vab19790h/Mechatronics-Project-Arduino-code/Scan from 2022-03-25 11_27_54 PM.jpg

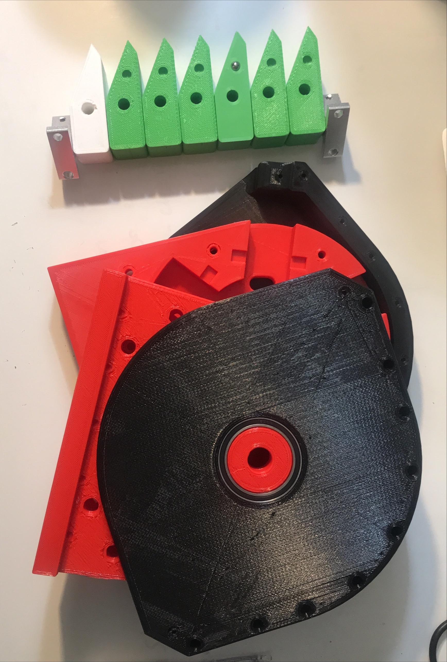
Scan from 2022-03-25 11_27_54 PM.jpg
