vab19790h/Mechatronics-Project-Arduino-code/I1.jpg

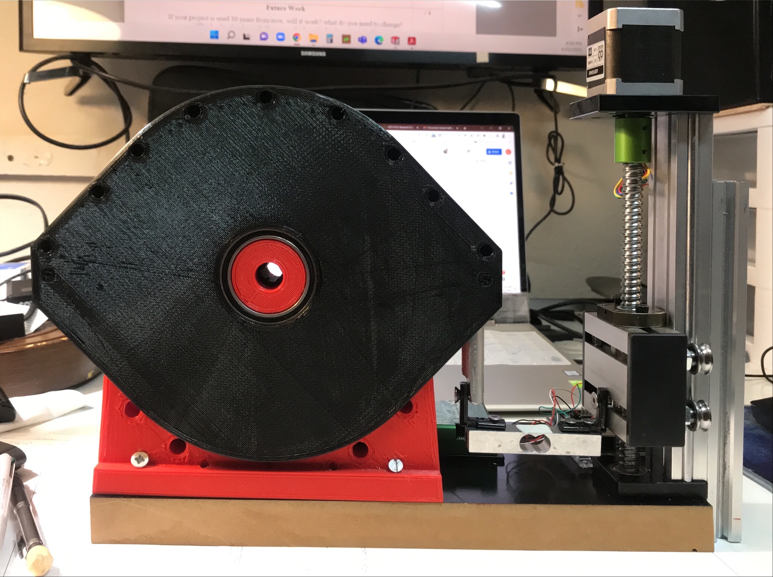
I1.jpg
