vab19790h/Mechatronics-Project-Arduino-code/Final Project Report_Mechatronics_VB.pdf

1

## Final Project Report: Mechatronics

## Title: Radial Force Measurement System (RFMS) for Flow Diverters and Stents

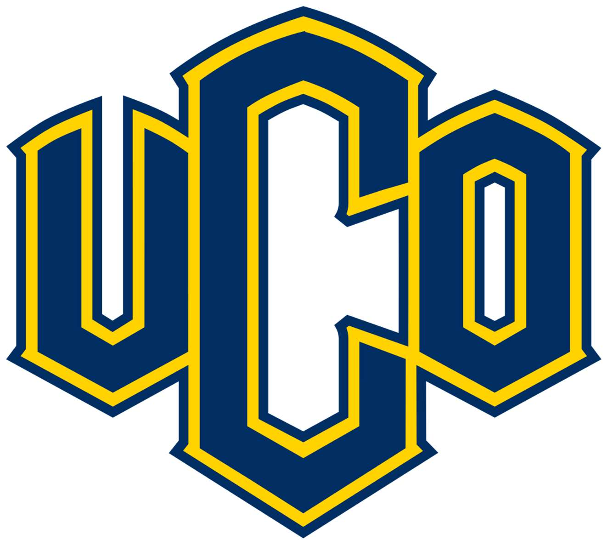
[picture p3: figure]

Spring 2022

Academic Advisor 1: Dr. Nesreen Alsbou Academic Advisor 2: Dr. Abdellah Ait Moussa Academic Advisor 3: Dr. Mohammad Robi Hossan

By
Vishal Barot

2

## Abstract

In the research of developing Biodegradable Flow Diverters by Dr. Hossan and his team, analyzing the mechanical properties of the developed flow diverters are one of the most crucial subsections. The flow diverters have a mesh-like structure in a tubular form and investigate the radial force related to the hoop stress of the material in one of the requirements for the analysis of mechanical properties of the Flow Diverters produced by the team of researchers at UCO. The machine required to analyze this property is available in the market at a relatively high cost and also It would not be sensible to buy equipment that could only serve one purpose especially when It can be developed by engineering students if provided enough incentive and support. This solution is to develop a mechanism that would radially compress the stent to a smaller diameter while registering the force or pressure difference. This data can be later interpreted via a proper calibration of the system. The solution will save a considerable amount of expense while allowing students to have an invaluable chance of learning many aspects of developing a mechanism and a system that would be functional and applicable to the research work.

## Introduction

The current environment requires flow diverters to be non-permanent in the body to reduce the possibility of developing complications like late thrombosis and restenosis after having a metallic flow diverter being inserted in the brain arteries to cure the condition of a brain aneurysm. The Brain Aneurysm is the bulging of an area of the blood vessel mainly due to the weakening of the walls of the arteries. This formation is known as an aneurysm which could be fatal if ruptures. The use of flow diverters to cure the condition of the brain aneurysm is quite popular in the medical field due to its noninvasive method to cure the condition. Producing a biodegradable/bioresorbable flow diverter can not only cure the condition of brain aneurysm but also biodegrade over time and reduce or avoid the disadvantages that come along with the permanency of metallic flow diverters. In a manner to push forward, the research and development of such flow diverters will only help the current environment of health conditions of human beings. So, In a manner to further the process, the requirement of investigating the mechanical properties of the developed flow diverter is crucial. And If that goal can be achieved without making hefty expenses on the research budget would be considered a much better solution.

3

## Proposed Solution

Develop a mechanism that would radially compress the flow diverters and allow an electronic system to detect and collect the force versus displacement data during the testing process. The prototype of the mechanism can be 3D printed. The loadcell can be utilized to detect force variation using an Arduino and the data can be transmitted to a computer for data acquisition through a Bluetooth module. The mechanism can be operated using a power screw and stepper motor controlled again via an Arduino

## Design and Prototype

| The Prototype will register and collect radial force measurements. The following
fig. 1 demonstrates the schematics of the Initial Idea.

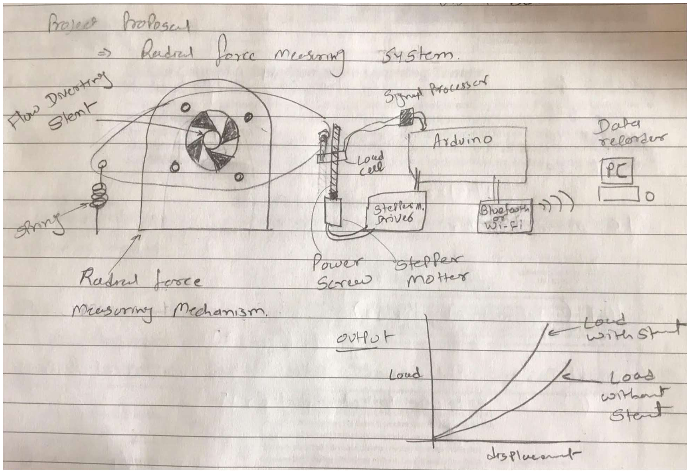
[picture p4: figure]

Fig. 1 Rough Schematics for the Radial Force Measurement Device

The following Fig. 2 demonstrates the flowchart of the functionality of the prototype. The flow diverter will be inserted into the mechanism which will be mechanically operated via a lead or power screw mechanism operated through a

4

stepper motor. The mechanism will also be connected to the load cell to register and collect the force measurement data through the radial compression of the flow diverters. Both load cell and stepper motor (via stepper motor driver) will be operated and controlled using an Arduino Uno microcontroller. The logical programming would initiate the test, collect the data during the radial compression and export the data to the monitoring computer via Bluetooth connectivity.

Fig. 2 Flowchart of the RFMS

Fig.3 illustrates the 3D modeling and simulation stage of the project and Fig 4 demonstrates the process of manufacturing the components of the mechanism using the additive manufacturing process.

Flow
Diverter

Radial
Force

Lead
Screw
Load Cell | Stepper Motor

Arduino

Computer

Bluetooth
Module

5

## Gantt chart for completing the project on time

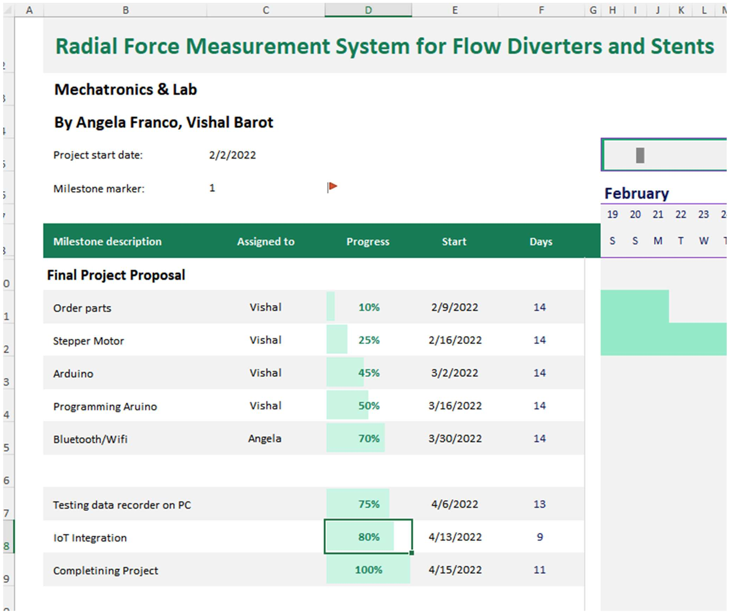
[picture p5: figure]
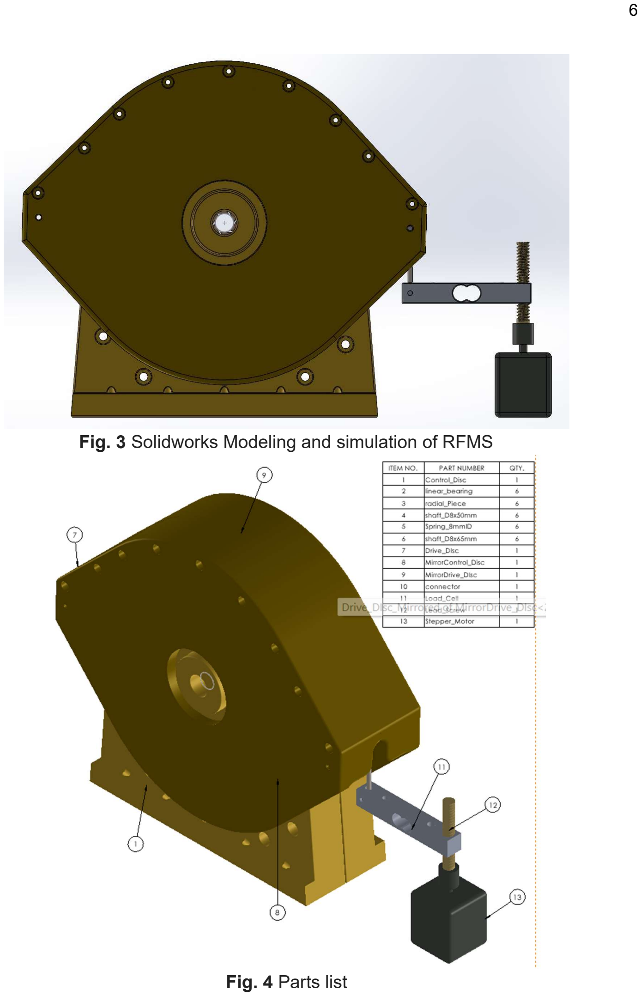
[picture p6: page 6]

6

Fig. 3 Solidworks Modeling and simulation of RFMS

Fig. 4 Parts list

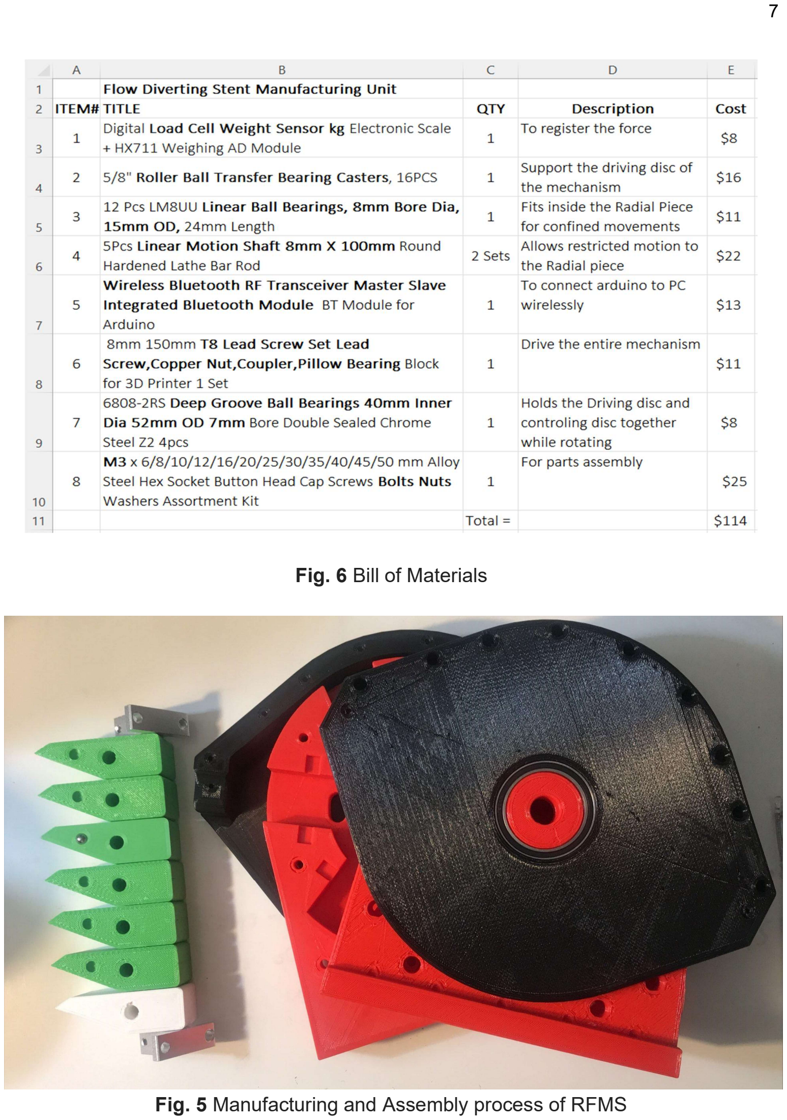
[picture p7: page 7]

7

Fig. 6 Bill of Materials

Fig. 5 Manufacturing and Assembly process of RFMS

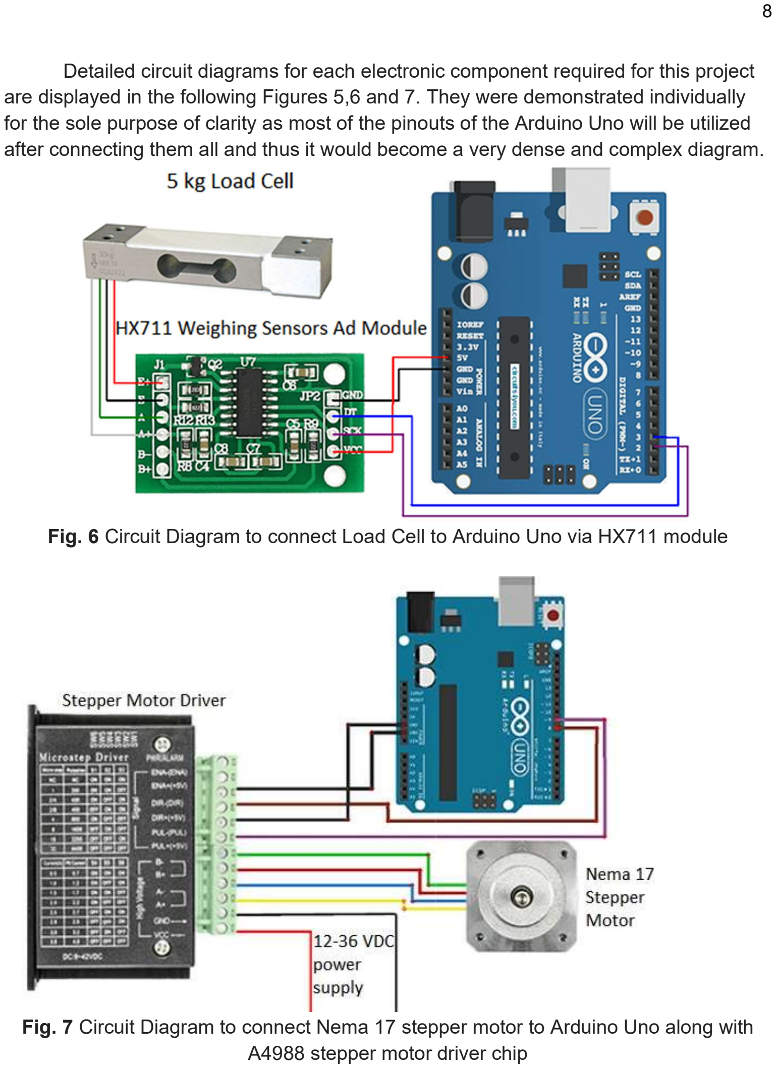
[picture p8: page 8]

8

| Detailed circuit diagrams for each electronic component required for this project
are displayed in the following Figures 5,6 and 7. They were demonstrated individually for the sole purpose of clarity as most of the pinouts of the Arduino Uno will be utilized after connecting them all and thus it would become a very dense and complex diagram.

Fig. 6 Circuit Diagram to connect Load Cell to Arduino Uno via HX711 module

Fig. 7 Circuit Diagram to connect Nema 17 stepper motor to Arduino Uno along with A4988 stepper motor driver chip

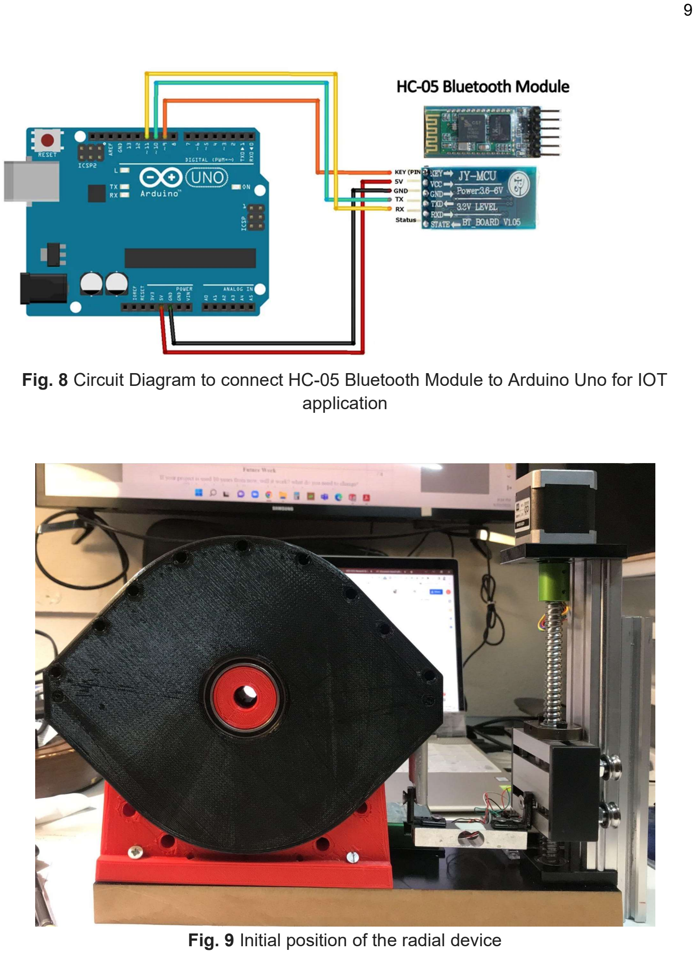
[picture p9: page 9]

9

Fig. 8 Circuit Diagram to connect HC-05 Bluetooth Module to Arduino Uno for IOT application

Fig. 9 Initial position of the radial device

10

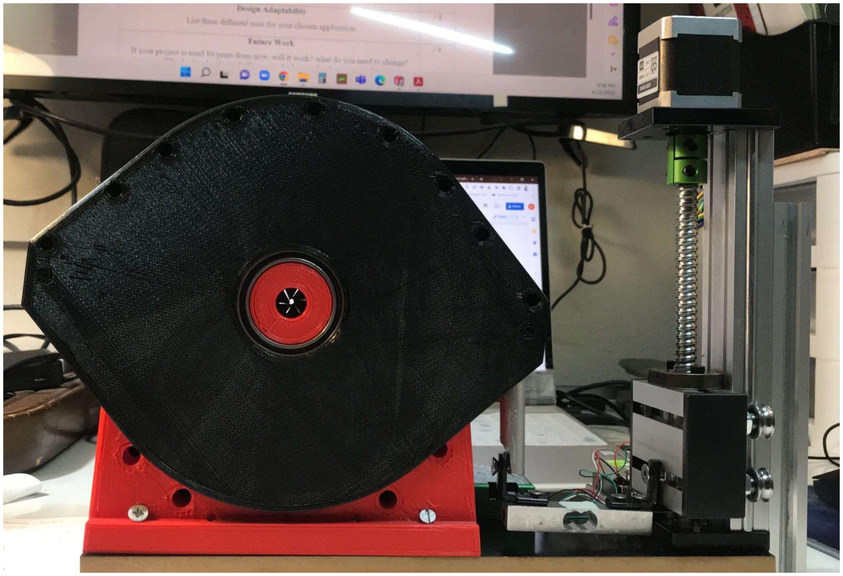
[picture p10: figure]

Fig. 10 Final position of the radial device

| Figures 8 and 9 demonstrate the completed project with its ideal position when
the radial mechanism is fully open to about 13 mm in diameter in Fig. 8 and closed down to about 1 mm diameter in Fig 9. The process of reducing the diameter through the mechanism will compress the flow diverter which will result in detecting a larger force value to estimate the radial force produced by the flow diverter.
| Click the link to watch the design and demonstration with some background
review of the project. https://youtu.be/eQT90Z1PZ-U

11

## Design Adaptability

Since the project is heavily concentrated on performing one task of measuring radial force, It can be used to measure radial compressive strength related to hoop stress of any flexible material with a cylindrical shape. It can be used to test pressurized flexible tubing to estimate the pressure of the tube without intruding into the fluid pipeline which is what most instruments do to measure the pressure of a pipeline. With certain modifications in mechanism, It can perform several types of mechanical testings that require force within the range of the load cell. There are several load cells available in the market with a higher capacity which can be an applicable variety of mechanical testing.

## Future Work

My project will work longer than 10 years if handled properly and performed regular maintenance and parts replacements in case of failure. But to make it highly accurate and precise, the parts of the mechanism should be manufactured out of metal and not from 3D printed materials via the CNC machining process and other industrialgrade manufacturing processes. Also, the load cell and microcontroller should be replaced with more reliable, high-quality replacements to ensure long-term consistent performance.

## Design Considerations and Engineering Standards

ISO 25539-1:2017: Cardiovascular implants — Endovascular devices — Part 1: Endovascular prostheses
ISO 25539-2:2012: Cardiovascular implants — Endovascular devices — Part 2: Vascular stents
ASTM F3067: Guide for Radial Loading of Balloon Expandable and Self Expanding Vascular Stents

12

## References

[1] Yu, Zhen, et al. “Design and Calibration of Torque Measurement System of Comprehensive Performance Test Instrument of Industrial Robot Reducer.” Computational Intelligence and Neuroscience, vol. 2022, Hindawi, 2022, pp. 8155818–8155818, https://doi.org/10.1155/2022/8155818.
[2] Maragkos, Georgios A., et al. “Overview of Different Flow Diverters and Flow Dynamics.” Neurosurgery, vol. 86, no. Supplement_1, Oxford University Press, 2020, pp. S21–S34, https://doi.org/10.1093/neuros/nyz323.
[3] Huang, Chenxi, et al. “A Deep Segmentation Network of Stent Structs Based on IoT for Interventional Cardiovascular Diagnosis.” IEEE Wireless Communications, vol. 28, no. 3, IEEE, 2021, pp. 36–43, https://doi.org/10.1109/MWC.001.2000407.
[4] Hoare, Daniel, et al. “The Future of Cardiovascular Stents: Bioresorbable and Integrated Biosensor Technology.” Advanced Science, vol. 6, no. 20, John Wiley & Sons, Inc, 2019, p. 1900856–n/a, https://doi.org/10.1002/advs.201900856.
[5] Link, Antonia, et al. “In Vitro Investigation of an Intracranial Flow Diverter with a Fibrin-Based, Hemostasis Mimicking, Nanocoating.” Biomedical Materials (Bristol), vol. 16, no. 1, IOP Publishing, 2020, pp. 015026–015026, https://doi.org/10.1088/1748-605X/abc8d3.
