vab19790h/Mechatronics-Project-Arduino-code/Screenshot 2022-03-25 225828.jpg

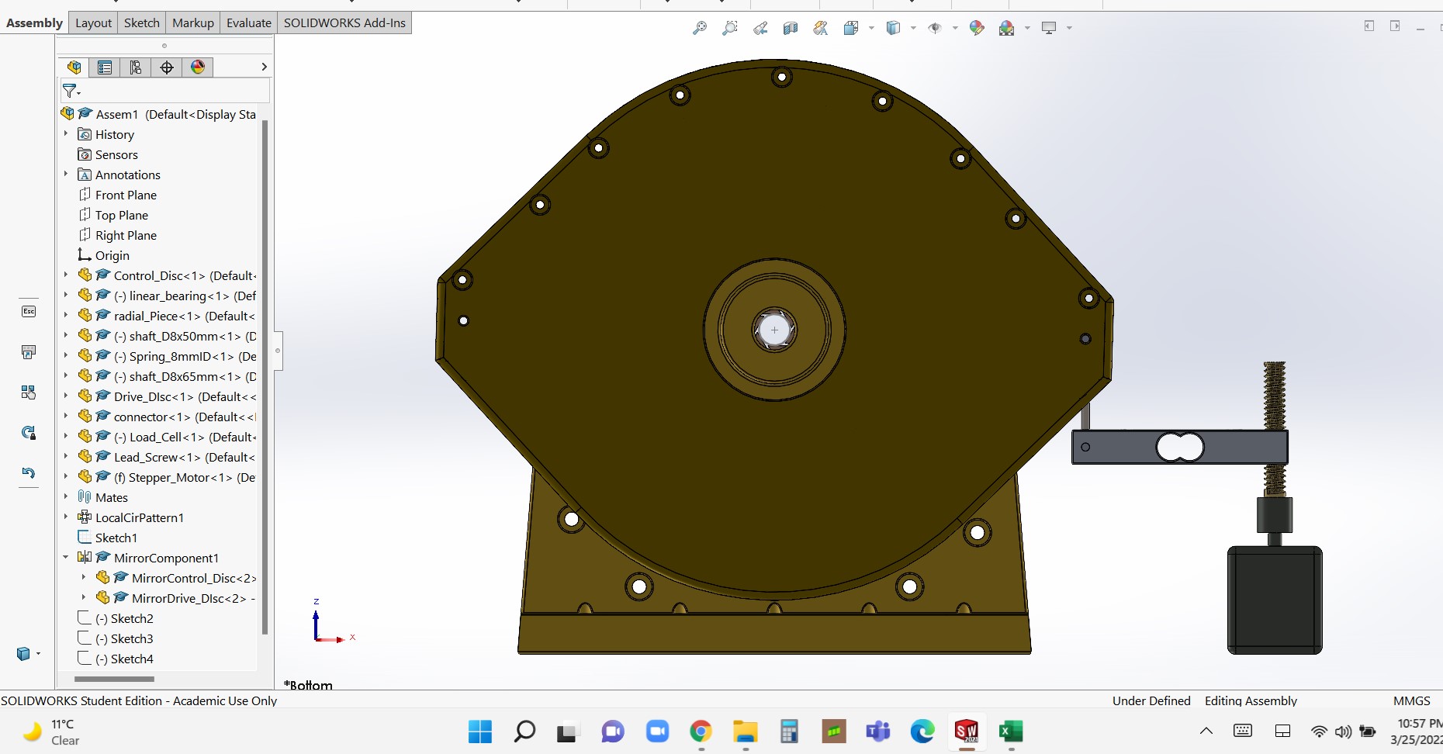
Screenshot 2022-03-25 225828.jpg
