vab19790h/Mechatronics-Project-Arduino-code/Screenshot 2022-04-25 134411.jpg

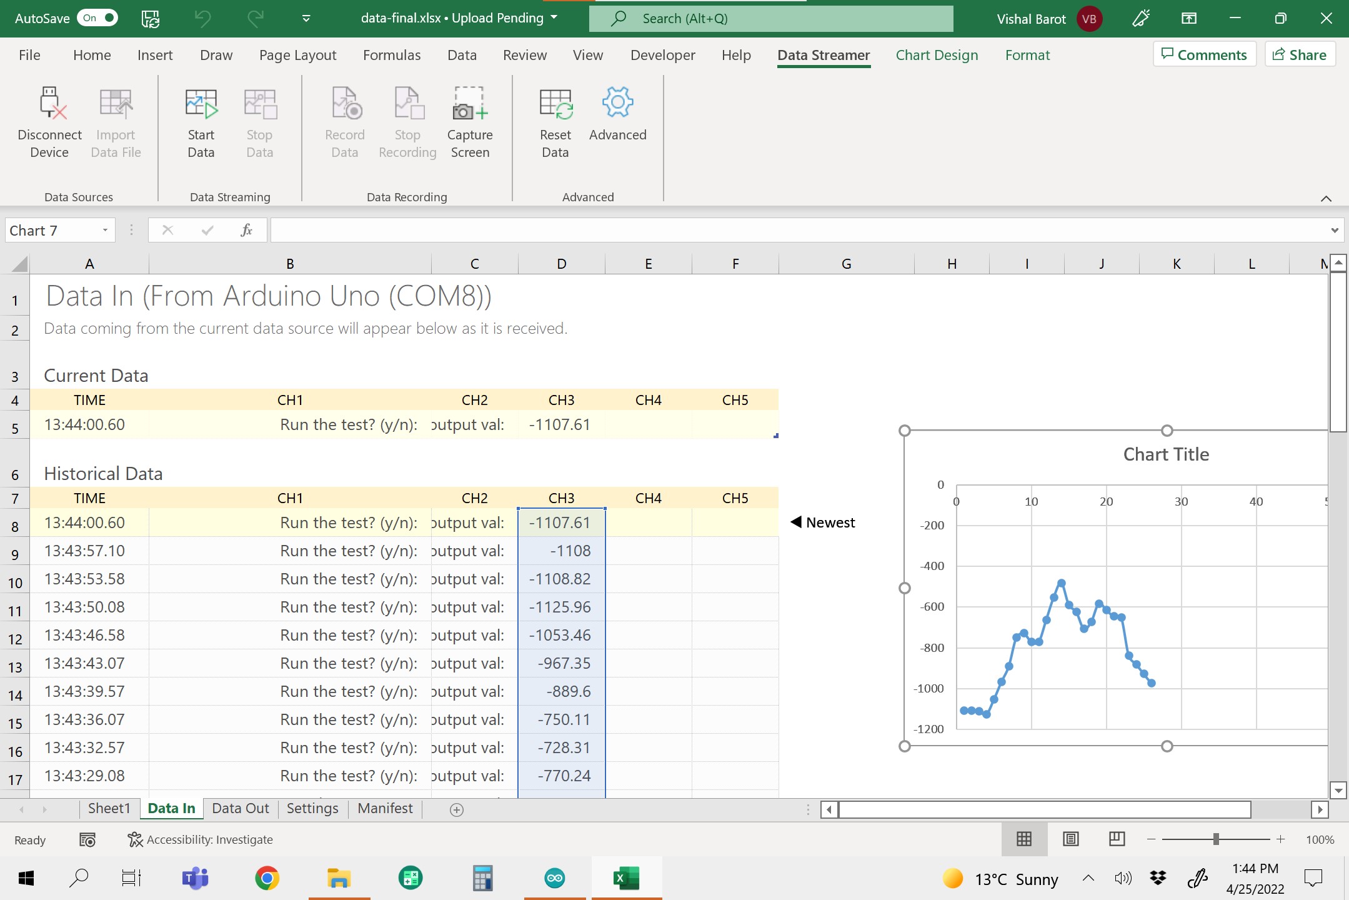
Screenshot 2022-04-25 134411.jpg
