vab19790h/Mechatronics-Project-Arduino-code/data-final.xlsx

Sheet: Data In
Data In (From Arduino Uno (COM8))
Data coming from the current data source will appear below as it is received.
Current Data
TIME | CH1 | CH2 | CH3 | CH4 | CH5 | CH6 | CH7 | CH8 | CH9 | CH10
16:32:52 | Run the test? (y/n): | Force: | -724.83
Historical Data
TIME | CH1 | CH2 | CH3 | CH4 | CH5 | CH6 | CH7 | CH8 | CH9 | CH10
16:32:52 | Run the test? (y/n): | Force: | -724.83
16:32:48 | Run the test? (y/n): | Force: | -723.26
16:32:45 | Run the test? (y/n): | Force: | -576.56
16:32:41 | Run the test? (y/n): | Force: | -576.72
16:32:38 | Run the test? (y/n): | Force: | -723.57
16:32:34 | Run the test? (y/n): | Force: | -725.41
16:32:31 | Run the test? (y/n): | Force: | -725.57
16:32:27 | Run the test? (y/n): | Force: | -708.52
16:32:24 | Run the test? (y/n): | Force: | -753.27
16:32:20 | Run the test? (y/n): | Force: | -763.02
16:32:17 | Run the test? (y/n): | Force: | -787.33
16:32:13 | Run the test? (y/n): | Force: | -752.53
16:32:10 | Run the test? (y/n): | Force: | -768.41
16:32:06 | Run the test? (y/n): | Force: | -768.41
16:32:03 | Run the test? (y/n): | Force: | -890.72
16:31:59 | Run the test? (y/n): | Force: | -914.65
16:31:56 | Run the test? (y/n): | Force: | -897.4
16:31:52 | Run the test? (y/n): | Force: | -999.06
16:31:49 | Run the test? (y/n): | Force: | -1143.04
16:31:45 | Run the test? (y/n): | Force: | -996.53
16:31:42 | Run the test? (y/n): | Force: | -995.74
16:31:38 | Run the test? (y/n): | Force: | -1142.79
16:31:35 | Run the test? (y/n): | Force: | -1139.46
16:31:31 | Run the test? (y/n): | Force: | -1139.24
16:31:28 | Run the test? (y/n): | Force: | -1139.51
16:31:24 | Run the test? (y/n): | Force: | -1258.44
16:31:21 | Run the test? (y/n): | Force: | -1186.24
16:31:17 | Run the test? (y/n): | Force: | -1323.69
16:31:14 | Run the test? (y/n): | Force: | -1299.48
16:31:10 | Run the test? (y/n): | Force: | -1335.02
16:31:07 | Run the test? (y/n): | Force: | -1336.96
16:31:03 | Run the test? (y/n): | Force: | -1354.73
16:31:00 | Run the test? (y/n): | Force: | -1250.24
16:30:56 | Run the test? (y/n): | Force: | -1255.76
16:30:53 | Run the test? (y/n): | Force: | -1380.74
16:30:49 | Run the test? (y/n): | Force: | -1246.38
16:30:46 | Run the test? (y/n): | Force: | -1085.31
16:30:42 | Run the test? (y/n): | Force: | -1067.92
16:30:39 | Run the test? (y/n): | Force: | -1051.52
16:30:35 | Run the test? (y/n): | Force: | -905.03
16:30:32 | Run the test? (y/n): | Force: | -761.9
16:30:28 | Run the test? (y/n): | Force: | -738.57
16:30:25 | Run the test? (y/n): | Force: | -809.18
16:30:21 | Run the test? (y/n): | Force: | -708.24
16:30:18 | Run the test? (y/n): | Force: | -708.42
16:30:14 | Run the test? (y/n): | Force: | -708.1
16:30:11 | Run the test? (y/n): | Force: | -741.66
16:30:07 | Run the test? (y/n): | Force: | -676.24
16:30:03 | Run the test? (y/n): | Force: | -658.87
16:30:00 | Run the test? (y/n): | Force: | -674.46

Sheet: Data Out
Data Out (To Device)
Data entered into the channels below will be sent to the currently connected device as a comma-delimited string.
CH1 | CH2 | CH3 | CH4 | CH5 | CH6 | CH7 | CH8 | CH9 | CH10

Sheet: Settings
Workbook Settings
Settings below will affect how data is read into the current workbook from data sources. Clear a field's contents to revert to its default setting.
Data interval (ms) | 150 | 150
Data rows | 15 | 50
Data channels | 10 | 10
Data orientation | Newest last | Newest first
WARNING: Changing settings may result in the loss of content and/or custom formatting in the Data In and Data Out worksheets. Always save before changing values.

Sheet: Manifest
Arduino Uno |  |  |  |  |  |  |  |  | {"Channels":[{"Description":null,"Id":null,"IsGhost":false,"Name":null,"Status":"Active","SubChannels":[{"Description":null,"Id":"CH1","IsGhost":false,"Name":"CH1","Status":"Active","SubChannels":[],"UnitOfMeasure":null},{"Description":null,"Id":"CH2","IsGhost":false,"Name":"CH2","Status":"Active","SubChannels":[],"UnitOfMeasure":null},{"Description":null,"Id":"CH3","IsGhost":false,"Name":"CH3","Status":"Active","SubChannels":[],"UnitOfMeasure":null},{"Description":null,"Id":"CH4","IsGhost":false,"Name":"CH4","Status":"Active","SubChannels":[],"UnitOfMeasure":null},{"Description":null,"Id":"CH5","IsGhost":false,"Name":"CH5","Status":"Active","SubChannels":[],"UnitOfMeasure":null},{"Description":null,"Id":"CH6","IsGhost":false,"Name":"CH6","Status":"Active","SubChannels":[],"UnitOfMeasure":null},{"Description":null,"Id":"CH7","IsGhost":false,"Name":"CH7","Status":"Active","SubChannels":[],"UnitOfMeasure":null},{"Description":null,"Id":"CH8","IsGhost":false,"Name":"CH8","Status":"Active","SubChannels":[],"UnitOfMeasure":null},{"Description":null,"Id":"CH9","IsGhost":false,"Name":"CH9","Status":"Active","SubChannels":[],"UnitOfMeasure":null},{"Description":null,"Id":"CH10","IsGhost":false,"Name":"CH10","Status":"Active","SubChannels":[],"UnitOfMeasure":null}],"UnitOfMeasure":null}],"Commands":[],"DataInterval":150,"Id":"AE4756A6-ADE2-4C1D-B451-592A89C576C3","IsGenerated":true,"Name":"Arduino Uno","Version":null,"BaudRate":9600}
This manifest was generated for the connected device. You can edit the device name and channel data here and the Data In worksheet will be updated.
 | Channels
 |  |  |  |  |  |  | Data Source Id
 |  | Id | Name | Description | Unit of Measure | Active | AE4756A6-ADE2-4C1D-B451-592A89C576C3 | 1
 |  | CH1 | CH1 |  |  | ü | Data Interval (ms)
 |  | CH2 | CH2 |  |  | ü | 150
 |  | CH3 | CH3 |  |  | ü | Baud Rate
 |  | CH4 | CH4 |  |  | ü | 9600
 |  | CH5 | CH5 |  |  | ü
 |  | CH6 | CH6 |  |  | ü
 |  | CH7 | CH7 |  |  | ü
 |  | CH8 | CH8 |  |  | ü
 |  | CH9 | CH9 |  |  | ü
 |  | CH10 | CH10 |  |  | ü
